novirium/ESPilot/pdf/ESPilot.pdf

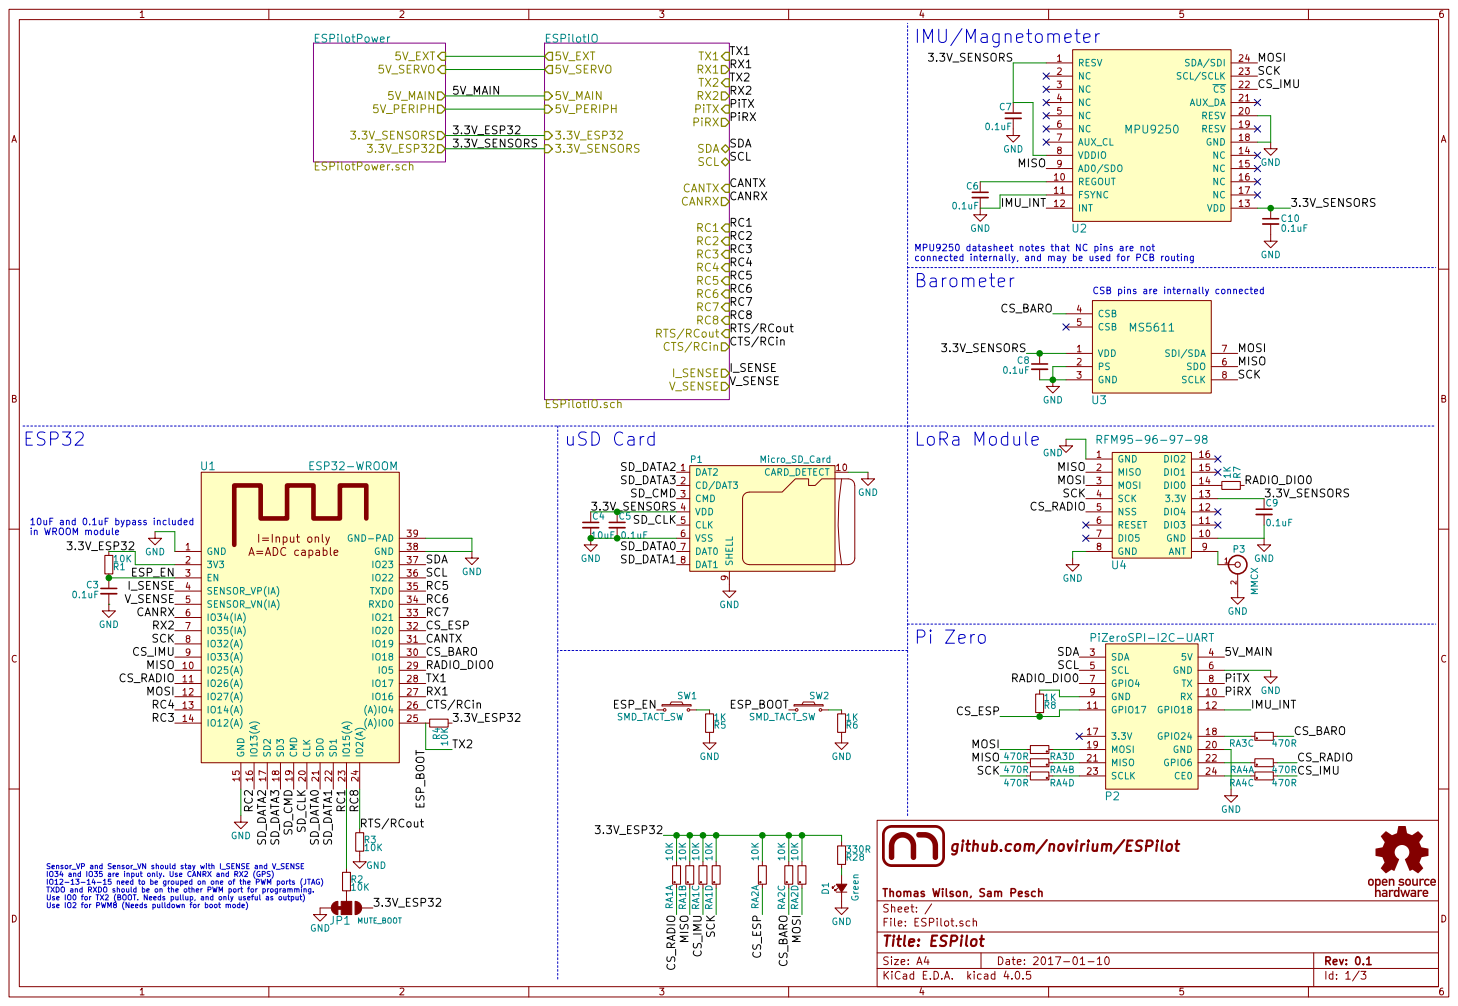
[picture p1: page 1]

MPU9250 datasheet notes that NC pins are not
connected internally, and may be used for PCB routing
Barometer

CSB pins are internally connected

github.com/novirium/ESPilot

Sensor_VP and Sensor_VN should stay with I_SENSE and V_SENSE
IO34 and IO35 are input only. Use CANRX and RX2 (GPS)

Id: 1/3 Title: ESPilot File: ESPilot.sch Sheet: / Thomas Wilson, Sam Pesch

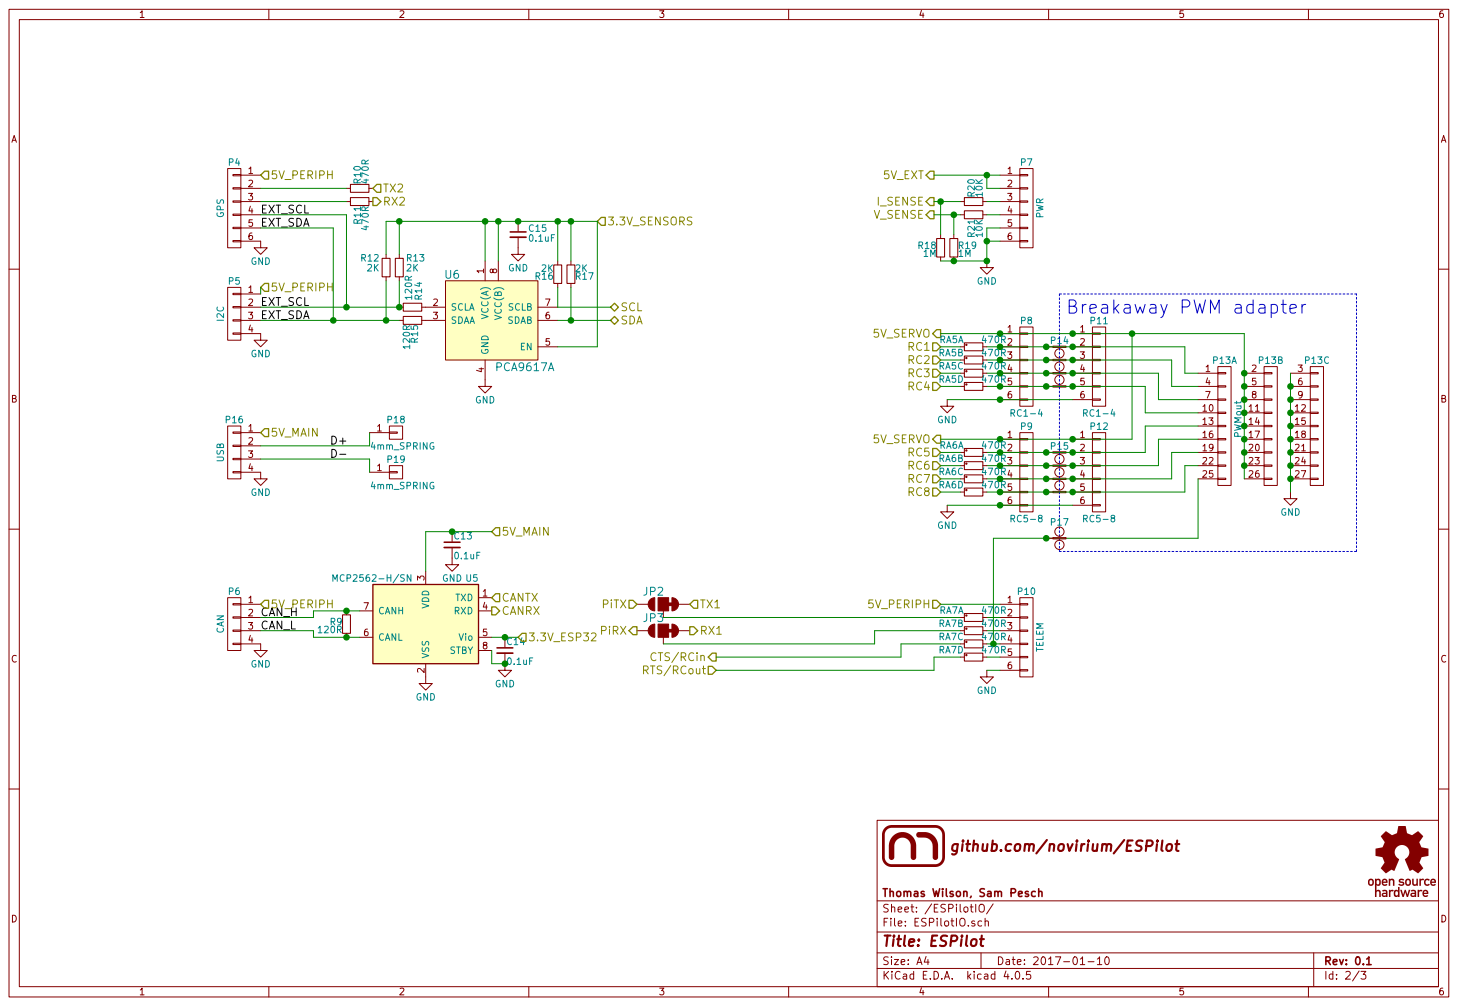
[picture p2: page 2]

5 | EXT_SDA

4 EN 5 SDAB 6 SCLB 7 VCC(B) 8U6 PCA9617A

3 | EXT_SDA

3 RXD 4 Vio 5 CANL 6 CANH 7 STBY 8 MCP2562-H/SN U5 GND GND

github.com/novirium/ESPilot 1

Id: 2/3 Title: ESPilot File: ESPilotIO.sch Sheet: /ESPilotIO/ Thomas Wilson, Sam Pesch

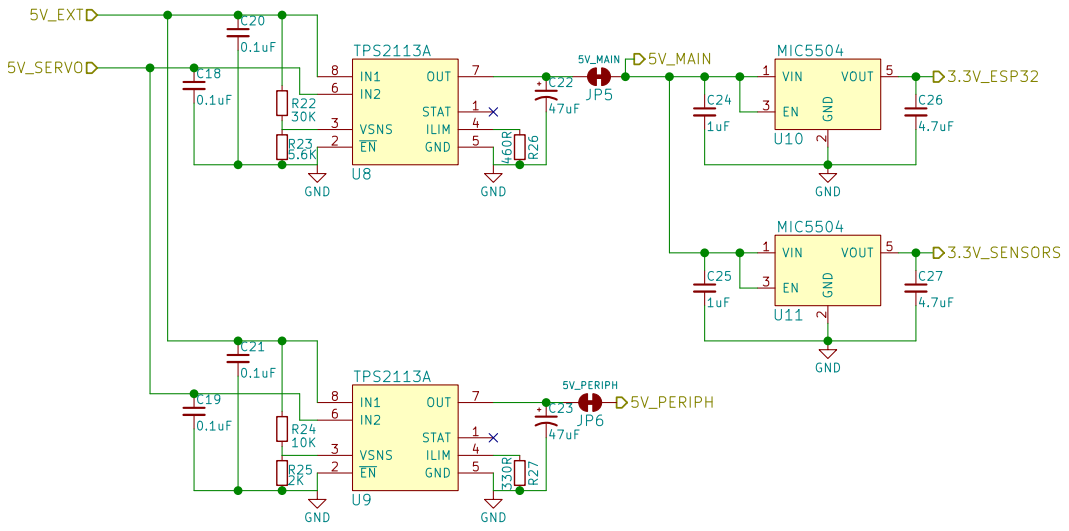
[picture p3: page 3]

github.com/novirium/ESPilot

Id: 3/3 Title: ESPilot File: ESPilotPower.sch Sheet: /ESPilotPower/ Thomas Wilson, Sam Pesch
