novirium/ESPilot/ESPilot.kicad_pcb

## KiCad design ESPilot.kicad_pcb (2017-01-10)

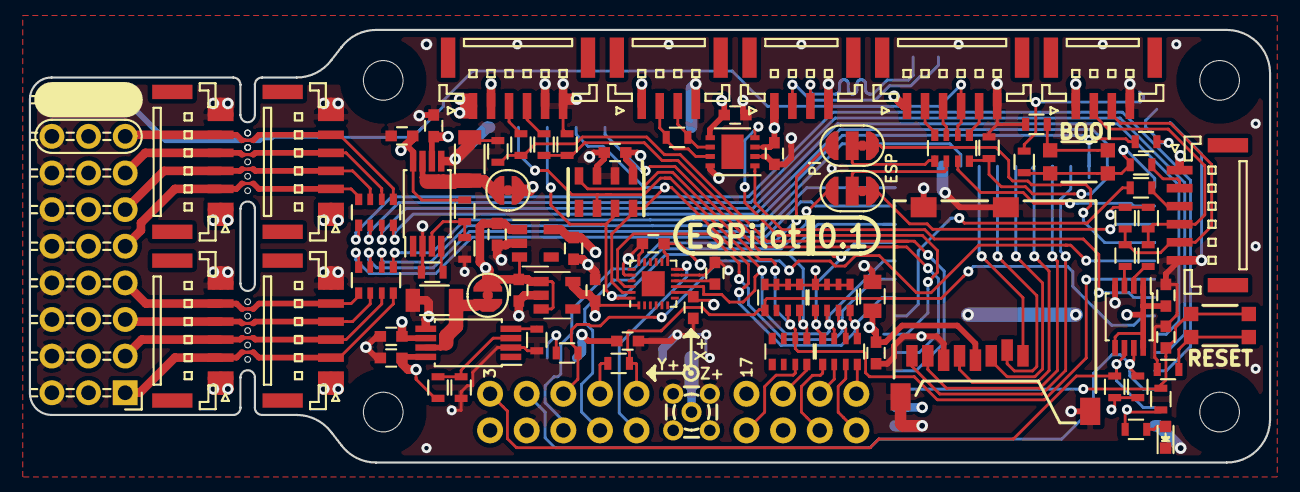
[picture p4: board ESPilot.kicad_pcb from above]

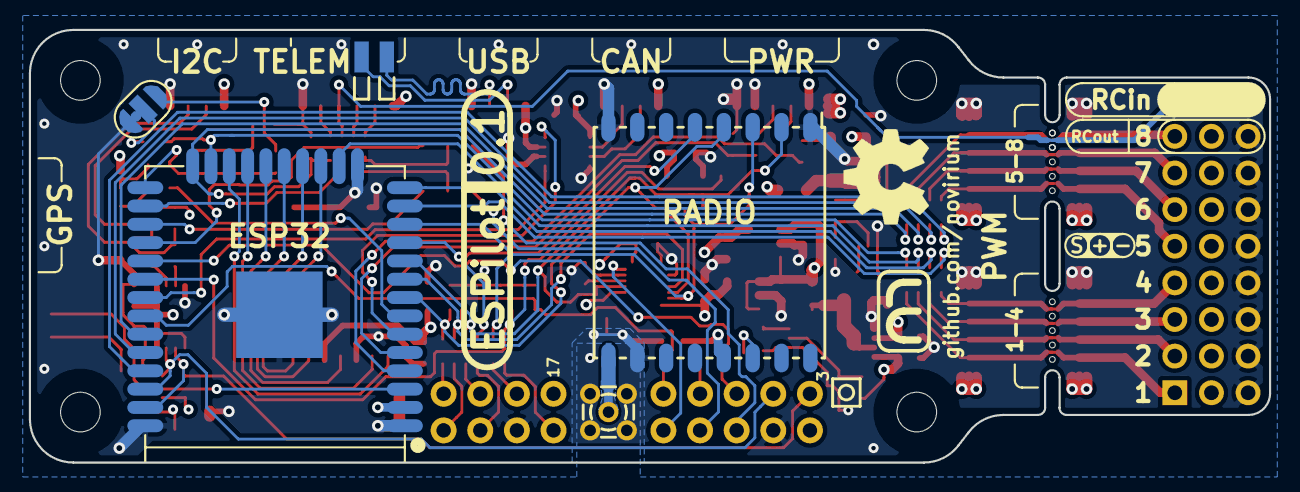
[picture p5: board ESPilot.kicad_pcb from below]

Board: 4 copper layers, 86.0 x 30.0 mm, 93 parts (7 on the bottom side), 90 nets.

Parts:
C3, C5, C6, C7, C8, C9, C10, C13, C14, C15, C18, C19, C20, C21: 0.1uF; C_0603
C4: 10uF; C_0805
C22, C23: 47uF; C_1206
C24, C25: 1uF; C_0603
C26, C27: 4.7uF; C_0603
D1: Led_Small; LED_0603
JP1, JP2, JP3: JUMPER_OPT; Jumper_Opt-2mm-0.5mm_gap
JP5, JP6: JUMPER_NC; Jumper_NC-2mm-0.5mm_gap
P1: Micro_SD_Card; uSD_CARD_101-00581-59
P2: PiZeroSPI-I2C-UART; PiZero-SPI-I2C-UART_5-3
P3: MMCX; RF-CONN-MMCX
P4: GPS; JST_GH_BM06B-GHS-TBT_06x1.25mm_Straight
P5: I2C; JST_GH_BM04B-GHS-TBT_04x1.25mm_Straight
P6: CAN; JST_GH_BM04B-GHS-TBT_04x1.25mm_Straight
P7: PWR; JST_GH_BM06B-GHS-TBT_06x1.25mm_Straight
P8, P11: RC1-4; JST_GH_BM06B-GHS-TBT_06x1.25mm_Straight
P9, P12: RC5-8; JST_GH_BM06B-GHS-TBT_06x1.25mm_Straight
P10: TELEM; JST_GH_BM06B-GHS-TBT_06x1.25mm_Straight
P13: PWMout; Pin_Header_Angled_3x09
P14, P15: BREAKAWAY_01X06; 4_pin_0.4mm_breakaway
P16: USB; JST_GH_BM04B-GHS-TBT_04x1.25mm_Straight
P17: BREAKAWAY_01X01; 1_pin_0.4mm_breakaway
P18, P19: CONN_01X01; Spring_Contact_IIC_Cannon_Z_Series
R1, R2, R3, R4, R20, R21, R24: 10K; R_0603
R5, R6, R7, R8: 1K; R_0603
R9, R14, R15: 120R; R_0603
R10, R11: 470R; R_0603
R12, R13, R16, R17, R25: 2K; R_0603
R18, R19: 1M; R_0603
R22: 30K; R_0603
R23: 5.6K; R_0603
R26: 460R; R_0603
R27, R28: 330R; R_0603
RA1, RA2: 10K; R_Array_Convex_4x0603
RA3, RA4, RA5, RA6, RA7: 470R; R_Array_Convex_4x0603
SW1, SW2: SW_PUSH_SMALL_H; SMD_TACT_4.2x2.8mm
U1: ESP32-WROOM
U2: MPU9250; QFN-24-1EP_3x3mm_Pitch0.4mm
U3: MS5611
U4: RFM95-96-97-98; RFM95
U5: MCP2562-H/SN; DFN-8-1EP_3x3mm_Pitch0.65mm
U6: PCA9617A; TSSOP-8_3x3mm_Pitch0.65mm
U8, U9: TPS2113A; TSSOP-8_4.4x3mm_Pitch0.65mm
U10, U11: MIC5504; SOT-23-5

Connections:
/3.3V_ESP32: C14.1, C27.1, JP1.3, R1.2, R4.2, R28.2, RA1.5, RA1.6, RA1.7, RA1.8, RA2.5, RA2.6, RA2.8, U1.2, U5.5, U11.5
/3.3V_SENSORS: C4.1, C5.1, C7.1, C8.1, C9.1, C10.1, C15.1, C26.1, P1.4, R12.1, R13.1, R16.2, R17.2, U2.1, U2.8, U2.13, U3.1, U4.13, U6.1, U6.5, U6.8, U10.5
/5V_MAIN: C13.1, C24.1, C25.1, JP5.2, P2.4, P16.1, U5.3, U10.1, U10.3, U11.1, U11.3
/CANRX: U1.6, U5.4
/CANTX: U1.31, U5.1
/CS_BARO: RA2.3, RA3.6, U1.30, U3.4
/CS_ESP: P2.11, R8.1, RA2.1, U1.32
/CS_IMU: RA1.3, RA4.6, U1.9, U2.22
/CS_RADIO: RA1.1, RA4.8, U1.11, U4.5
/CTS/RCin: RA7.3, U1.26
/ESP_BOOT: R4.1, R10.2, SW2.1, U1.25
/ESP_EN: C3.1, R1.1, SW1.1, U1.3
/ESPilotIO/5V_EXT: C20.1, C21.1, P7.1, P7.2, R22.1, R24.1, U8.8, U9.8
/ESPilotIO/5V_PERIPH: JP6.2, P4.1, P5.1, P6.1, P10.1
/ESPilotIO/5V_SERVO: C18.1, C19.1, P8.1, P9.1, P11.1, P12.1, P13.2, P13.5, P13.8, P13.11, P13.14, P13.17, P13.20, P13.23, P13.26, U8.6, U9.6
/ESPilotIO/CAN_H: P6.2, R9.1, U5.7
/ESPilotIO/CAN_L: P6.3, R9.2, U5.6
/ESPilotIO/D+: P16.2, P18.1
/ESPilotIO/D-: P16.3, P19.1
/ESPilotIO/EXT_SCL: P4.4, P5.2, R13.2, R14.2
/ESPilotIO/EXT_SDA: P4.5, P5.3, R12.2, R15.2
/IMU_INT: P2.12, U2.12
/I_SENSE: R18.1, R20.1, U1.4
/MISO: RA1.2, RA4.7, U1.10, U2.9, U3.6, U4.2
/MOSI: RA2.4, RA3.5, U1.12, U2.24, U3.7, U4.3
/PiRX: JP3.3, P2.10
/PiTX: JP2.3, P2.8
/RADIO_DIO0: P2.7, R7.1, U1.29
/RC1: R2.1, RA5.1, U1.23
/RC2: RA5.2, U1.16
/RC3: RA5.3, U1.14
/RC4: RA5.4, U1.13
/RC5: RA6.1, U1.35
/RC6: RA6.2, U1.34
/RC7: RA6.3, U1.33
/RC8: R3.1, RA6.4, RA7.4, U1.24
/RX1: JP3.1, U1.27
/RX2: R11.2, U1.7
/SCK: RA1.4, RA4.5, U1.8, U2.23, U3.8, U4.4
/SCL: P2.5, R16.1, U1.36, U6.7
/SDA: P2.3, R17.1, U1.37, U6.6
/SD_CLK: P1.5, U1.20
/SD_CMD: P1.3, U1.19
/SD_DATA0: P1.7, U1.21
/SD_DATA1: P1.8, U1.22
/SD_DATA2: P1.1, U1.17
/SD_DATA3: P1.2, U1.18
/TX1: JP2.1, U1.28
/V_SENSE: R19.1, R21.1, U1.5
GND: C3.2, C4.2, C5.2, C6.2, C7.2, C8.2, C9.2, C10.2, C13.2, C14.2, C15.2, C18.2, C19.2, C20.2, C21.2, C22.2, C23.2, C24.2, C25.2, C26.2, C27.2, D1.1, JP1.1, P1.6, P1.9, P1.10, P2.6, P2.20, P3.2, P4.6, P5.4, P6.4, P7.5, P7.6, P8.6, P9.6, P10.6, P11.6, P12.6, P13.3, P13.6, P13.9, P13.12, P13.15, P13.18, P13.21, P13.24, P13.27, P16.4, R3.2, R5.1, R6.1, R18.2, R19.2, R23.2, R25.2, R26.2, R27.2, U1.1, U1.15, U1.38, U1.39, U2.11, U2.18, U2.20, U3.2, U3.3, U4.1, U4.8, U4.10, U5.2, U5.8, U6.4, U8.2, U8.5, U9.2, U9.5, U10.2, U11.2
unnamed: C6.1, U2.10
unnamed: C22.1, JP5.1, U8.7
unnamed: C23.1, JP6.1, U9.7
unnamed: D1.2, R28.1
unnamed: JP1.2, R2.2
unnamed: JP2.2, RA7.1
unnamed: JP3.2, RA7.2
unnamed: P2.9, R8.2
unnamed: P2.18, RA3.3
unnamed: P2.19, RA3.4
unnamed: P2.21, RA4.2
unnamed: P2.22, RA4.1
unnamed: P2.23, RA4.4
unnamed: P2.24, RA4.3
unnamed: P3.1, U4.9
unnamed: P4.2, R10.1
unnamed: P4.3, R11.1
unnamed: P7.3, R20.2
unnamed: P7.4, R21.2
unnamed: P10.2, RA7.8
unnamed: P10.3, RA7.7
unnamed: P10.4, P13.25, P17.1, RA7.6
unnamed: P10.5, RA7.5
unnamed: P8.2, P11.2, P13.1, P14.1, RA5.8
unnamed: P8.3, P11.3, P13.4, P14.2, RA5.7
unnamed: P8.4, P11.4, P13.7, P14.3, RA5.6
unnamed: P8.5, P11.5, P13.10, P14.4, RA5.5
unnamed: P9.2, P12.2, P13.13, P15.1, RA6.8
unnamed: P9.3, P12.3, P13.16, P15.2, RA6.7
unnamed: P9.4, P12.4, P13.19, P15.3, RA6.6
unnamed: P9.5, P12.5, P13.22, P15.4, RA6.5
unnamed: R5.2, SW1.2
unnamed: R6.2, SW2.2
unnamed: R7.2, U4.14
unnamed: R14.1, U6.2
unnamed: R15.1, U6.3
unnamed: R22.2, R23.1, U8.3
unnamed: R24.2, R25.1, U9.3
unnamed: R26.1, U8.4
unnamed: R27.1, U9.4
