novirium/ESPilot/(commit log)

2016-12-15 Initial commit. First schematic pass nearly finished.
    [ESPilot.sch, ESPilotIO.sch, ESPilotPower.sch]
2016-12-15 Generated schematic PDF
2016-12-16 Added component footprints
    [ESPilot.sch, ESPilotIO.sch, ESPilotPower.sch]
2016-12-16 Fixed wrong pin numbering
2017-01-10 PCB commit
    [ESPilot.kicad_pcb, ESPilot.sch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]
2017-01-10 Rotated two board edge arcs to show them properly in DirtyPCB layer viewer
    [ESPilot.kicad_pcb]
2017-06-03 Fix incorrect regulator part number and clean up some schematic lines
    [ESPilotIO.sch, ESPilotPower.sch]
2017-06-04 Removed production files - these will be packaged with tagged releases to correspond to board orders
    [ESPilot-B.Cu.gbl, ESPilot-B.Mask.gbs, ESPilot-B.SilkS.gbo, ESPilot-F.Cu.gtl, ESPilot-F.Mask.gts, ESPilot-F.SilkS.gto]
2017-06-04 Removed intermediate netlist file to reduce chance of an unsynchronised change between schematic and layout
